RingingResonance/400hz-Driver/README.txt

Firmware and MPLAB project files located in  '400HZdriver.X'

Schematic located in '400hzDriver'

PDF schematic is also in the driectory '400hzDriver'

The current firmware starts the ciruit off at 60hz for a few seconds to give the user time to reset the GFCI if needed. It will then ramp up to 400hz.
Choose parts based on your (mains voltage * 4) you plan on using.

I've recently upgraded the firmware so that it is easier to change parameters such as output frequency, PWM frequency, and wave type. You must still edit the code and recompile to make these changes. Later I plan on adding dip switches or jumpers for these configurations. I may plan on making this a full inverter drive/controll system so for now I'm leaving plenty of I/O for future options.

The IR2104 doesn't have the current driving capability for fast PWM. I have changed the schematic to use asymetric gate driving to help the mosfets turn off before the 500ns deadtime is up on the IR2104. Use appropriate PNP transistors and resistors for this part of the circuit.
Don't oversize your fuses.
Circuit diagram was made AFTER I built the circuit. It may not be exact to what I have built and needs to be thorughly looked at and understood before attemting to build.
The ENTIRE circuit is live when plugged in, the output has no neutral, they are both HOT.

Not for beginners. Build at your own risk!

Enjoy your flickerless LED xmass lights!

I'm still experimenting with different fets and with the asymmetric gate drive. I'm not going to put down any part numbers until I have something that works well.

Also, I have the firmware currently set to produce a sine wave with a PWM frequency of 50khz.The output lowpass filter could be improved.
