RingingResonance/400hz-Driver/400hzDriver/400hzDriver.pdf

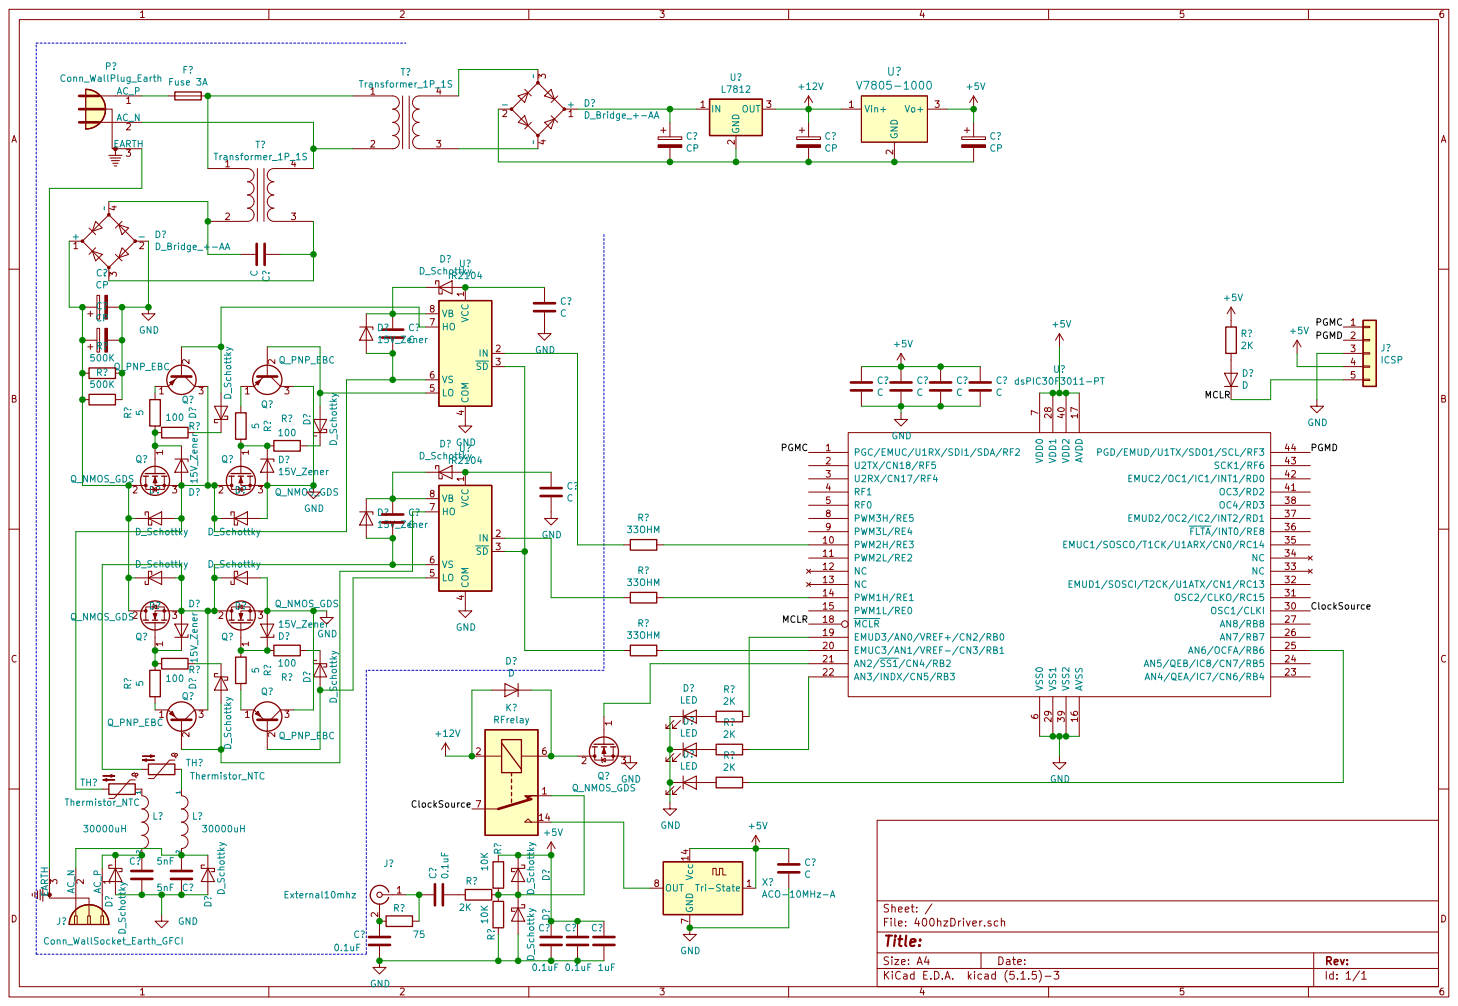
[picture p1: page 1]

7 PWM3H/RE5 8 PWM3L/RE4 9 PWM2H/RE3 10 EMUC3/AN1/VREF-/CN3/RB1 20 OSC1/CLKI 30 VDD2 40 PWM2L/RE2 11 AN2/SS1/CN4/RB2 21 OSC2/CLKO/RC15 31 OC3/RD2 41 NC 12 AN3/INDX/CN5/RB3 22 EMUD1/SOSCI/T2CK/U1ATX/CN1/RC13 32 EMUC2/OC1/IC1/INT1/RD0 42 NC 13 AN4/QEA/IC7/CN6/RB4 23 NC 33 SCK1/RF6 43 PWM1H/RE1 14 AN5/QEB/IC8/CN7/RB5 24 NC 34 PGD/EMUD/U1TX/SDO1/SCL/RF3 44 PWM1L/RE0 15 AN6/OCFA/RB6 25 EMUC1/SOSCO/T1CK/U1ARX/CN0/RC14 35 AVSS 16 AN7/RB7 26 FLTA/INT0/RE8 36 AVDD 17 AN8/RB8 27 EMUD2/OC2/IC2/INT2/RD1 37 MCLR 18 VDD1 28 OC4/RD3 38 EMUD3/AN0/VREF+/CN2/RB0 19 VSS1 29 VSS2 39 U?

Id: 1/1 Title: File: 400hzDriver.sch Sheet: / GND
