RingingResonance/400hz-Driver/400HZdriver.X/chipconfig.h

/* 
 * File:   chipconfig.h
 * 400HZ xmass light anti-flicker driver.
 * Author: Jarrett Cigainero
 *
 * Created on January 27, 2020, 5:07 PM
 */

#ifndef CHIPCONFIG_H
#define	CHIPCONFIG_H

#ifdef	__cplusplus
extern "C" {
#endif


// DSPIC30F3011 Configuration Bit Settings

// 'C' source line config statements

// FOSC
#pragma config FOSFPR = ECIO_PLL8        // Oscillator (XT w/PLL 8x)
#pragma config FCKSMEN = CSW_FSCM_ON   // Clock Switching and Monitor (Sw Disabled, Mon Disabled)

// FWDT
#pragma config FWPSB = WDTPSB_16        // WDT Prescaler B (1:16)
#pragma config FWPSA = WDTPSA_512       // WDT Prescaler A (1:512)
#pragma config WDT = WDT_OFF            // Watchdog Timer (Disabled)

// FBORPOR
#pragma config FPWRT = PWRT_64          // POR Timer Value (64ms)
#pragma config BODENV = BORV27          // Brown Out Voltage (Reserved)
#pragma config BOREN = PBOR_ON         // PBOR Enable (Disabled)
#pragma config LPOL = PWMxL_ACT_HI      // Low-side PWM Output Polarity (Active High)
#pragma config HPOL = PWMxH_ACT_HI      // High-side PWM Output Polarity (Active High)
#pragma config PWMPIN = RST_IOPIN       // PWM Output Pin Reset (Control with PORT/TRIS regs)
#pragma config MCLRE = MCLR_EN          // Master Clear Enable (Enabled)

// FGS
#pragma config GWRP = GWRP_OFF          // General Code Segment Write Protect (Disabled)
#pragma config GCP = CODE_PROT_OFF      // General Segment Code Protection (Disabled)

// FICD
#pragma config ICS = ICS_PGD            // Comm Channel Select (Use PGC/EMUC and PGD/EMUD)

// #pragma config statements should precede project file includes.
// Use project enums instead of #define for ON and OFF.

#include <xc.h>

#ifdef	__cplusplus
}
#endif

#endif	/* CHIPCONFIG_H */
