RingingResonance/400hz-Driver/(commit log)

2020-11-29 Added info for where firmware and schematics are located.
2020-11-30 Updated external 10mhz input. This has only been tested under simulation.
    [400hzDriver.sch]
2020-11-30 Updated PDF schematic.
2020-11-30 Added resistor to make external 10mhz signal 0 point at 2.5v
    [400hzDriver.sch]
2020-11-30 Another update to external 10mhz input isolation circuit. Updated PDF schematic.
    [400hzDriver.sch]
2020-12-01 Updated resistor values for FET turn off transistors. Updated PWM max dutycycle in firmware.
    [400hzDriver.sch]
2020-12-02 Slowed down frequency ramp up when set to 400hz.
2020-12-03 Updated Output Filtering.
    [400hzDriver.sch]
2020-12-03 Changed Power Up Timer from 8 to 64
2020-12-04 Set Brown Out Reset from 2V to 2.7V. Was having trouble getting micro to start. This seems to have fixed it.
    [chipconfig.h]
2020-12-04 Updated Output Filter. Seems to work well enough and doesn't draw too much idle current under simulation. Voltage may sag under higher loads however. Waiting for new parts to test in real life.
    [400hzDriver.sch]
2020-12-15 Reduced Max PWM duty cycle on output to compensate for IR2104.
2020-12-16 Added an easier way to enable/disable slow starting when frequency is set to 400hz.
